TiberiusGh/magic-wand/.img/IMG_4907.JPG

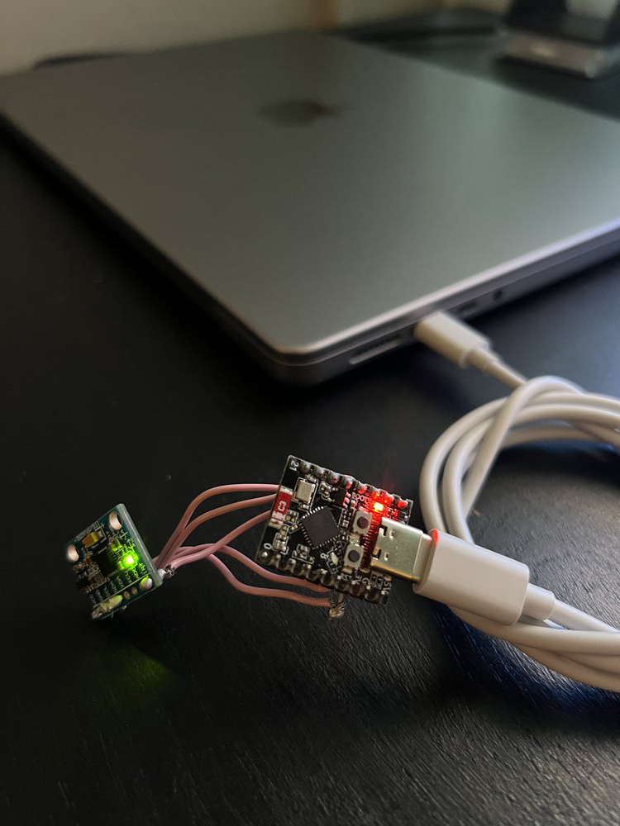
.img/IMG_4907.JPG
